Deepakbth/PCB-Design-of-Closed-Loop-Operation-of-Buck-Boost-Converter/README.md

# PCB-Design-of-Closed-Loop-Operation-of-Buck-Boost-Converter
