Deepakbth/PCB-Design-of-Closed-Loop-Operation-of-Buck-Boost-Converter/Report Buck Boost.pdf

INDIAN INSTITUTE OF TECHNOLOGY, GUWAHATI

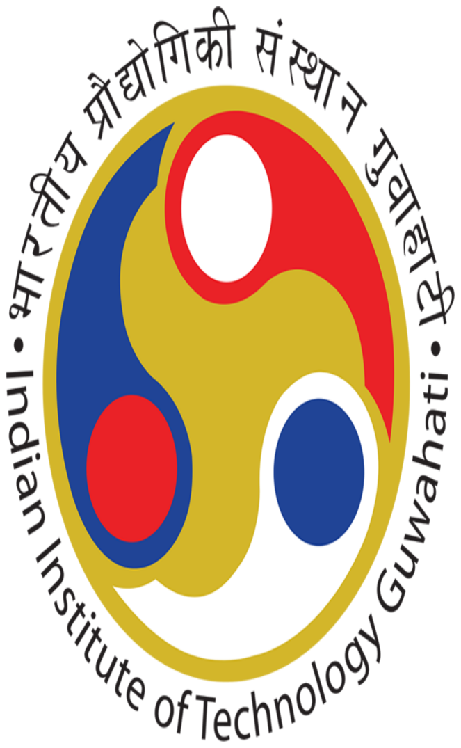
[picture p1: figure]

# PCB Design of Closed Loop Operation of Buck-Boost

# Converter

November 14, 2021

Deepak Kumar (214102111)
Cilaveni Satish Chandra(216102008)

## Objective

Realize a closed loop control of buck-boost converter controlled by analogue PI controller. The specifications for the buck-boost converter are given below.

## Specifications

Input Voltage (Vin): 96 V, Output Voltage (V0): 48 V and 150 V, Switching Frequency (fsw ): 20 kHz, Output Voltage Ripple (Vr ): 10 percent, Inductor Current Ripple (I Lr ) : 20 percent , Rated Power: 500 W.

## Circuit Diagram

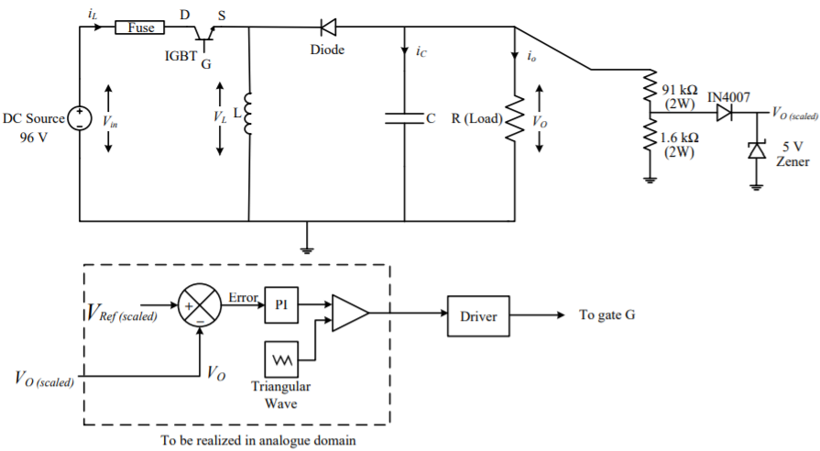
[picture p2: figure]

Figure 1: Buck-Boost Circuit

## Power circuit design

To design the power circuit firstly, the values D,V0 and R are calculated for buck and boost mode individually. After this step, the values of L and C are determined by the permissible current ripple and voltage ripple respectively.
If a load of resistance R and output ripple voltage Vr
is considered, then the minimum value of filter capacitance required is given by

Cmin =

D ∗V0
R ∗ fsw ∗Vr

The value of the inductor determines the boundary between the continuous and discontinuous conduction modes is given by

Lb =

(1−D)

2
R ∗ fsw

If input voltage Vin and ripple inductor current is ILr is considered, then the minimum value of inductor required is given by

Lr =

D ∗Vin
fsw ∗ I Lr

The results obtained by following the procedure discussed above are shown for buck and boost mode. In the buck mode (output voltage = 48 V)
Cmin = 3.7µF

Lb = 0.5mH

Lr = 0.512mH

In the boost mode(output voltage = 150 V) Cmin = 6.77µF

Lb = 0.1713mH

Lr = 1.7mH

After obtaining the critical values of L and C for both the cases, L and C are selected such that whose values are sufficiently larger than the ones calculated in the boost mode.
The values of power circuit used are L=2 mH, C=47 µF and R=45 Ω. All the devices are selected incorporating safety factor as 1.5. A RCD normal snubber circuit is also designed for the power electronic switch.

## Controller design

The control circuit has to generate the pulses for the gate driver.The control signal for gate pulse is obtained by comparing the reference signal obtained by the controller and triangular wave.
The Triangular wave is generated with the concept of square wave generator and integrator circuit using OP-AMPs. To generate the reference signal for comparing with the triangular wave we use a PI controller. The input of the PI controller is the scaled output voltage signal and scaled reference voltage signal required at the output.
The scaled output voltage signal is reduced form of equivalent output signal available at the output. It is scaled using an auxiliary circuit at the output side. The scaled output voltage signal and scaled reference signals are given as input for error generation. After this step, the error signal generated is given as input to the PI controller and the controller gives us the desired reference signal for comparing with the triangular wave to give pulses to the gate driver circuit.
The proportionality constant Kp is given by R6/R5 and integrator constant Ki

is given by 1/(R8∗C1). Resistor R9 allows bias current to bypass C1. Without R9, bias current on some general purpose, bipolar op-amps are large enough to charge C1 even with no error voltage. This causes the output of the integrator op-amp to slowly rise until it is saturated. R9 is taken an greater then 10∗R8.
The transfer function of a buck-boost converter is given below.

T F =

Vin
D ∗(1−D)

[

(1−D)

2 ∗R − s ∗D ∗L
s

2L ∗C ∗R + s ∗L +(1−D)

2 ∗R

]

The PI controller is designed using the values for the boost mode. That should make the controller work for the buck mode as well.
Thus, D = 0.61, L = 2 mH, C = 47µF, R = 45 Ω and Vin is 96V. Using these values in the above equation and simplifying, we get the transfer function as

G(s) =

4320−0.7687s
4.23∗(10)⁻⁶ ∗s

2 +0.002∗s +6.853

Therefore, the characteristic equation is written as

1+KG(s) = 0

4.23∗(10)⁻⁶ ∗s

2 +(0.002−0.7687K)∗s +(6.853+4320K) = 0

From Routh Hurwitz stability criterion, we obtain the below results

Kcr i t i cal = 0.0026

Kp = 0.6∗Kcr i t i cal = .0016

Ki =

Kcr i t i cal ∗w
pi

= 1.7

The formula for Kp and Ki are given by

Kp =

R6
R5

Ki =

1
R8C1

Thus accordingly R5, R6 values will be 100kΩ and 160Ω respectively and R8, C1 values will be 5.9k Ω and 10µF respectively.

## Simulation Results

Buck mode: V0 =48V, duty cycle D = 33.33 percent.

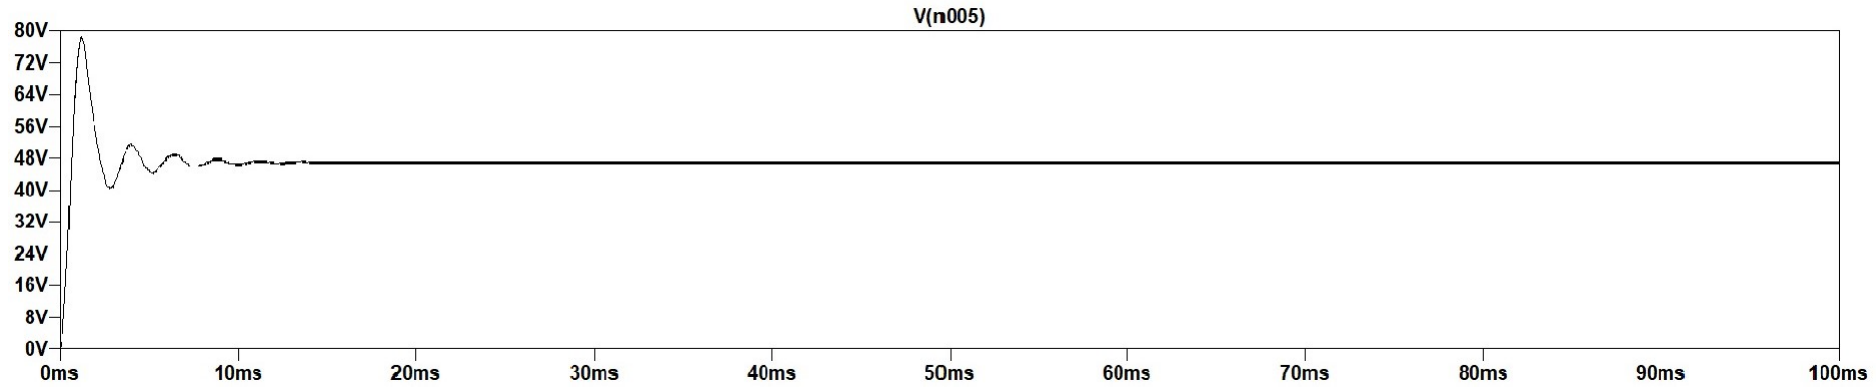
[picture p3: figure]

Figure 2: Output Voltage in Buck Mode

Boost mode: V0 =150V, duty cycle D = 61 percent.

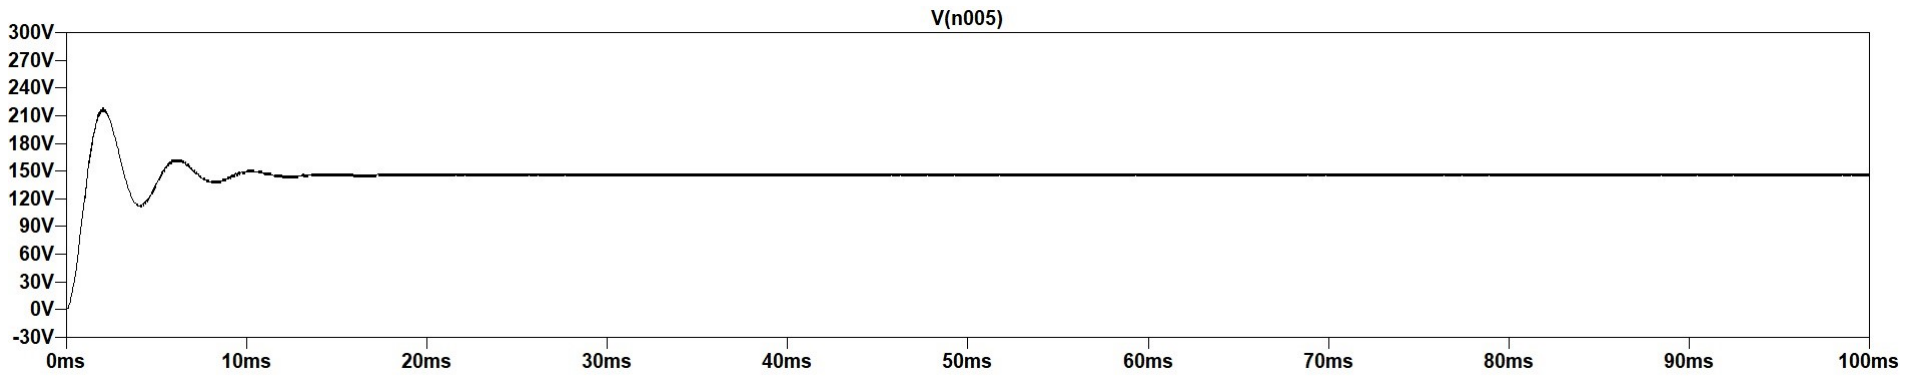
[picture p4: figure]

Figure 3: Output Voltage in Boost Mode

## PCB Designing

The PCB design is done using the EAGLE software. The components which were used in the simulation are used to create a eagle schematic file. The Board file is created from the schematic file. After that the connections are made accordingly and width of copper is chosen according to the current flowing. After Board connection is completely gerber files are generated using the CAM Processor and by using the software ZofzPCB the figure shown is obtained.

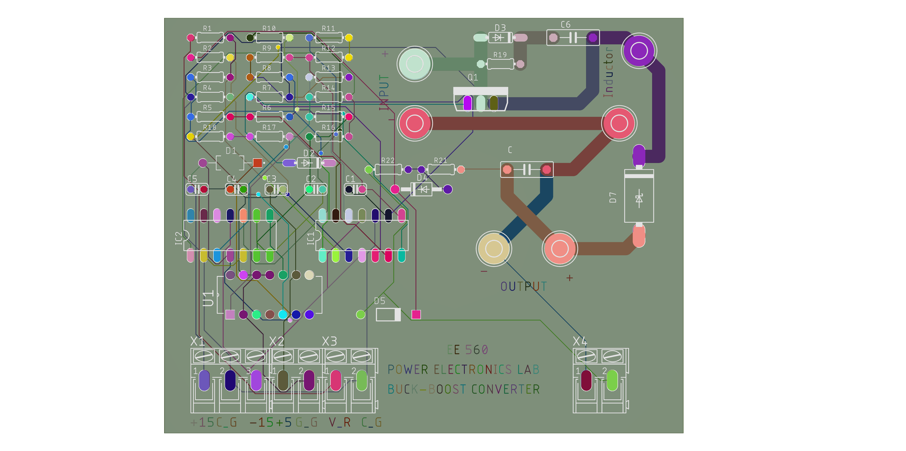
[picture p5: figure]

Figure 4: Final PCB Board

## Conclusion

The overall circuit is designed using analog circuits with the help of OP-AMPs. In the LT spice software the simulations are done,later PCB designing is done using EAGLE software and finally gerber files are generated for the closed loop operation of the Buck-Boost converter.
