Deepakbth/PCB-Design-of-Closed-Loop-Operation-of-Buck-Boost-Converter/labproject.brd

## EAGLE design labproject.brd (2022-09-26)

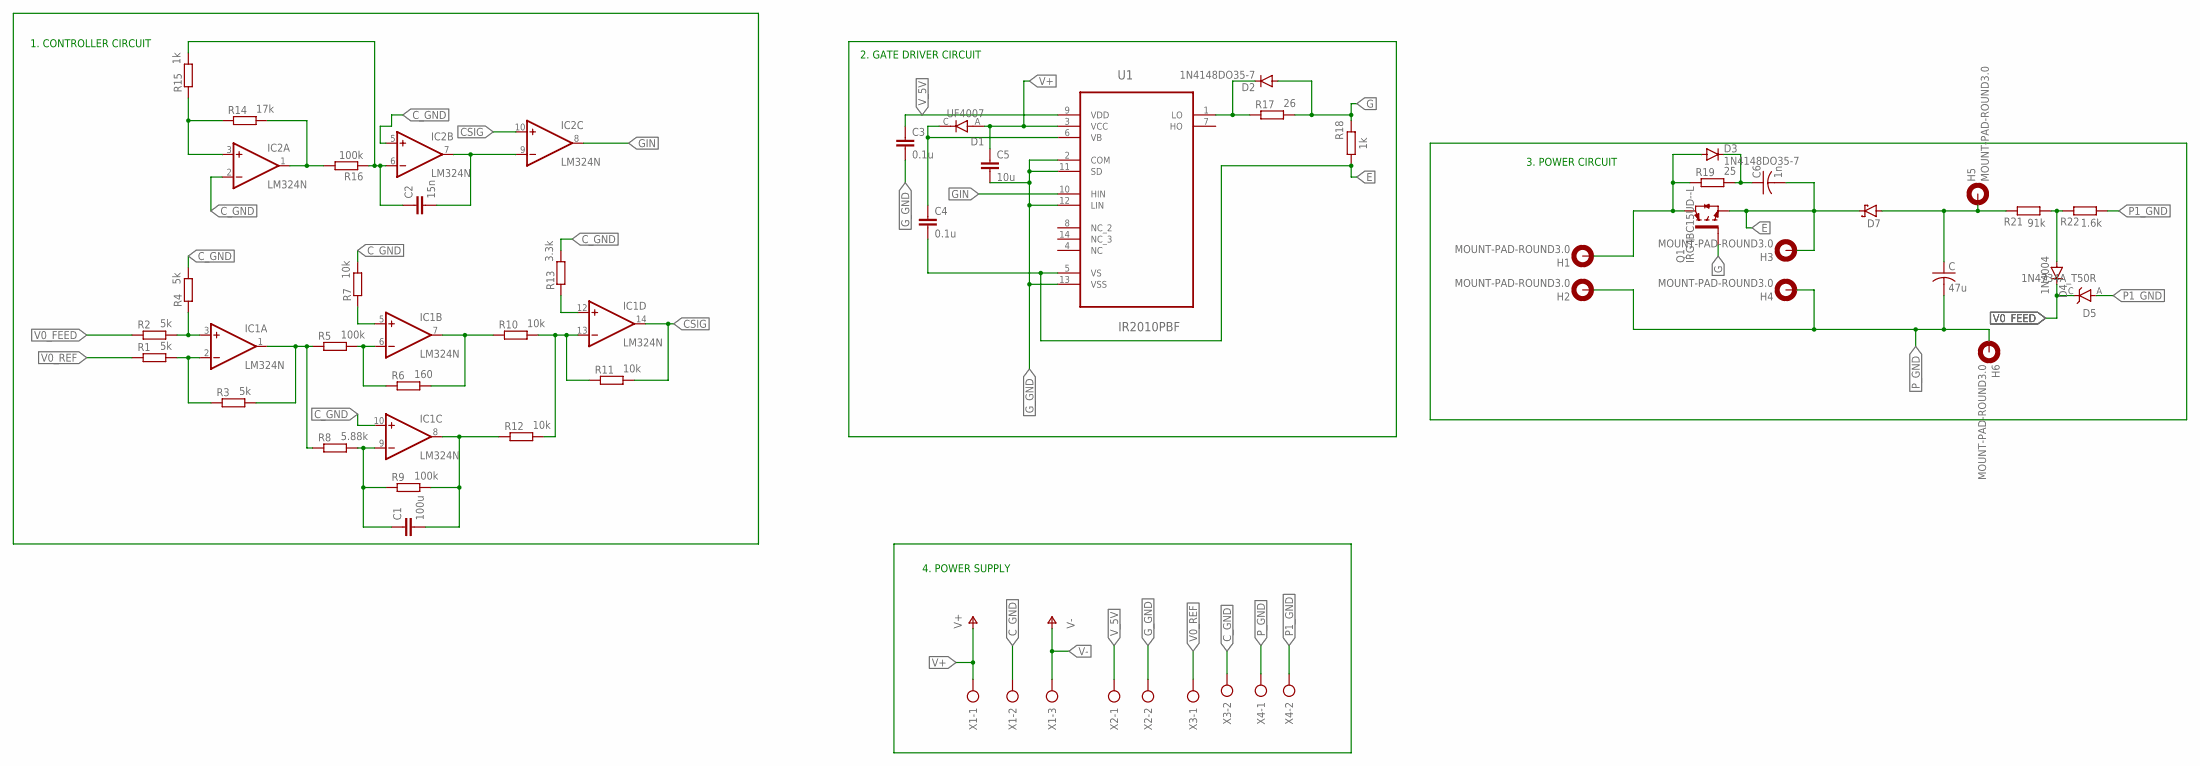
[picture p6: schematic labproject.sch]

Parts:
C: 47u; C075-032X103
C1: 100u; C025-024X044
C2: 15n; C025-024X044
C3, C4: 0.1u; C025-024X044
C5: 10u; C025-024X044
C6: 1n; C075-032X103
D1: UF4007; DIOAD1055W87L533D272
D2, D3: 1N4148DO35-7; DO35-7
D4: 1N4004; DO41-10
D5: 1N4734A_T50R; DIOAD1070W78L463D238P
D7: SCHOTTKY-DIODEDO201T15; DO201T15
H1, H2, H3, H4, H5, H6: MOUNT-PAD-ROUND3.0; 3,0-PAD
IC1, IC2: LM324N; DIL14
Q1: IRG4BC15UD--L; TO262-V
R1, R2, R3, R4: 5k; 0204/7
R5, R9, R16: 100k; 0204/7
R6: 160; 0204/7
R7, R10, R11, R12: 10k; 0204/7
R8: 5.88k; 0204/7
R13: 3.3k; 0204/7
R14: 17k; 0204/7
R15, R18: 1k; 0204/7
R17: 26; 0204/7
R19: 25; 0204/7
R21: 91k; 0204/7
R22: 1.6k; 0204/7
U1: IR2010PBF; DIP254P762X533-14
X1: AK300/3
X2, X3, X4: AK300/2

Connections:
CSIG: IC1.14 (OUT), IC2.10 (+IN), R11.2
C_GND: IC1.10 (+IN), IC2.2 (-IN), IC2.5 (+IN), R4.2, R7.2, R13.2, X1.2, X3.2
E: C4.2, C6.2, D7.C, H3.B3,0, Q1.3 (E), R18.2, U1.5 (VS)
G: D2.A, Q1.1 (G), R17.2, R18.1
GIN: IC2.8 (OUT), U1.10 (HIN)
G_GND: C3.2, C5.2, U1.2 (COM), U1.11 (SD), U1.12 (LIN), U1.13 (VSS), X2.2
unnamed: IC1.3 (+IN), R2.2, R4.1
unnamed: IC1.2 (-IN), R1.2, R3.1
unnamed: IC1.1 (OUT), R3.2, R5.1, R8.1
unnamed: IC1.6 (-IN), R5.2, R6.1
unnamed: IC1.5 (+IN), R7.1
unnamed: IC1.7 (OUT), R6.2, R10.1
unnamed: IC1.13 (-IN), R10.2, R11.1, R12.2
unnamed: C1.1, IC1.9 (-IN), R8.2, R9.1
unnamed: C1.2, IC1.8 (OUT), R9.2, R12.1
unnamed: IC1.12 (+IN), R13.1
unnamed: IC2.1 (OUT), R14.2, R16.2
unnamed: IC2.3 (+IN), R14.1, R15.1
unnamed: C2.1, IC2.6 (-IN), R15.2, R16.1
unnamed: C2.2, IC2.7 (OUT), IC2.9 (-IN)
unnamed: C4.1, D1.C (K), U1.6 (VB)
unnamed: D2.C, R17.1, U1.1 (LO)
unnamed: D3.A, H1.B3,0, Q1.2 (C), R19.1
unnamed: C6.1, D3.C, R19.2
unnamed: C.1, D7.A, H5.B3,0, R21.2
unnamed: D4.A, R21.1, R22.2
P1_GND: D5.A, R22.1, X4.2
P_GND: C.2, H2.B3,0, H4.B3,0, H6.B3,0, X4.1
V0_FEED: D4.C, D5.C, R2.1
V0_REF: R1.1, X3.1
V+: C5.1, D1.A, IC1.4 (V+), IC2.4 (V+), U1.3 (VCC), X1.1
V-: IC1.11 (V-), IC2.11 (V-), X1.3
V_5V: C3.1, U1.9 (VDD), X2.1

Notes on the sheet:
2. GATE DRIVER CIRCUIT
1. CONTROLLER CIRCUIT
4. POWER SUPPLY
3. POWER CIRCUIT

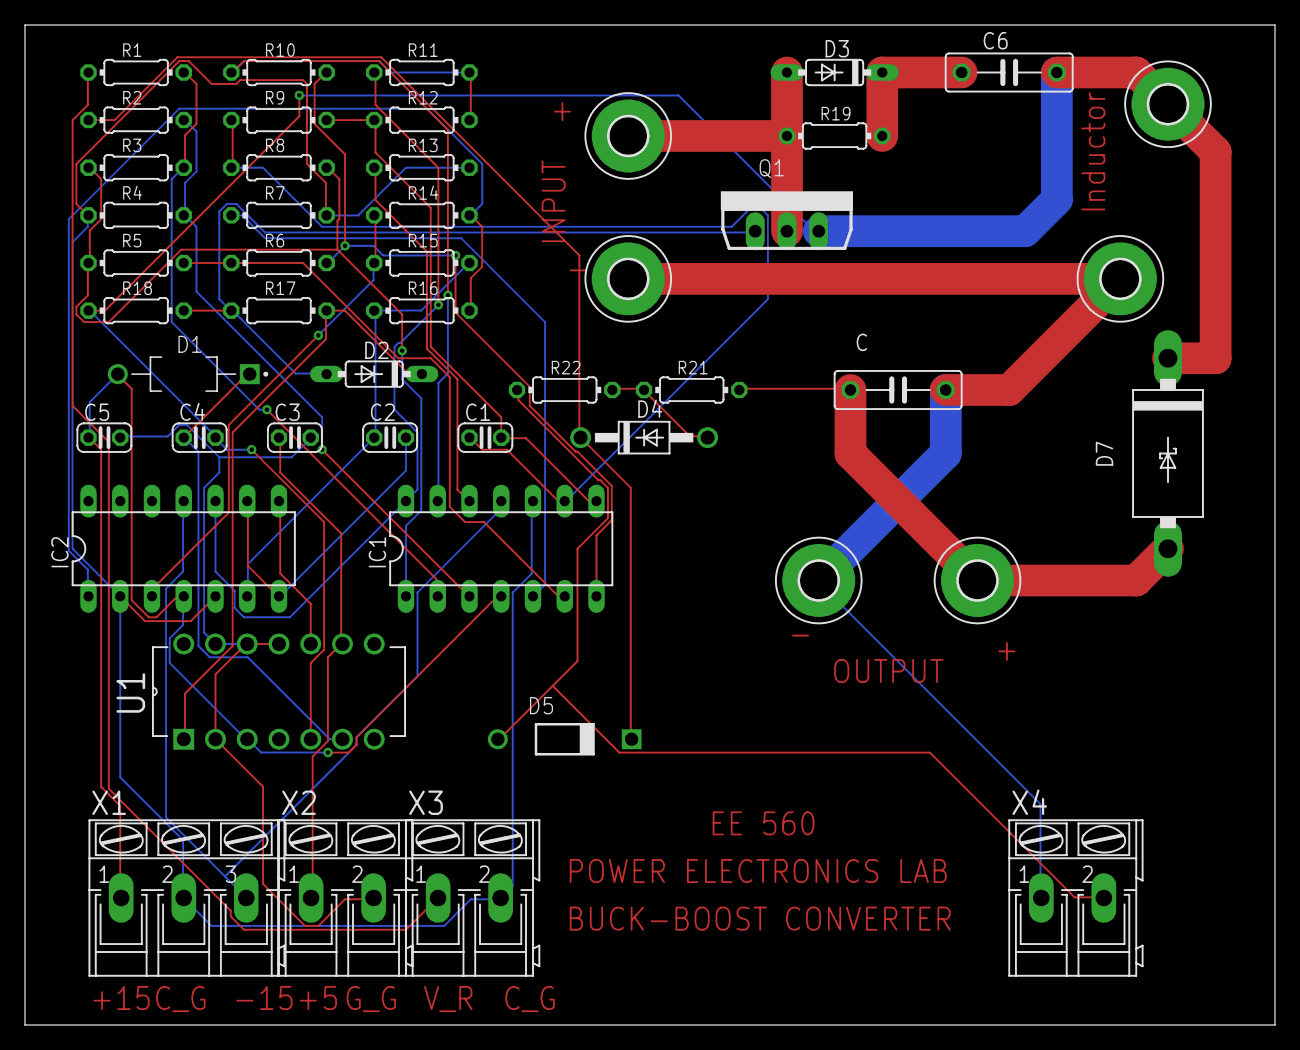
[picture p7: board labproject.brd from above]

Board: 2 copper layers, 100.0 x 80.0 mm, 48 parts (0 on the bottom side), 33 nets.
